ihartwig/pcie-mini-bridge/docs/five_pictures2_2542_20140408102417.png

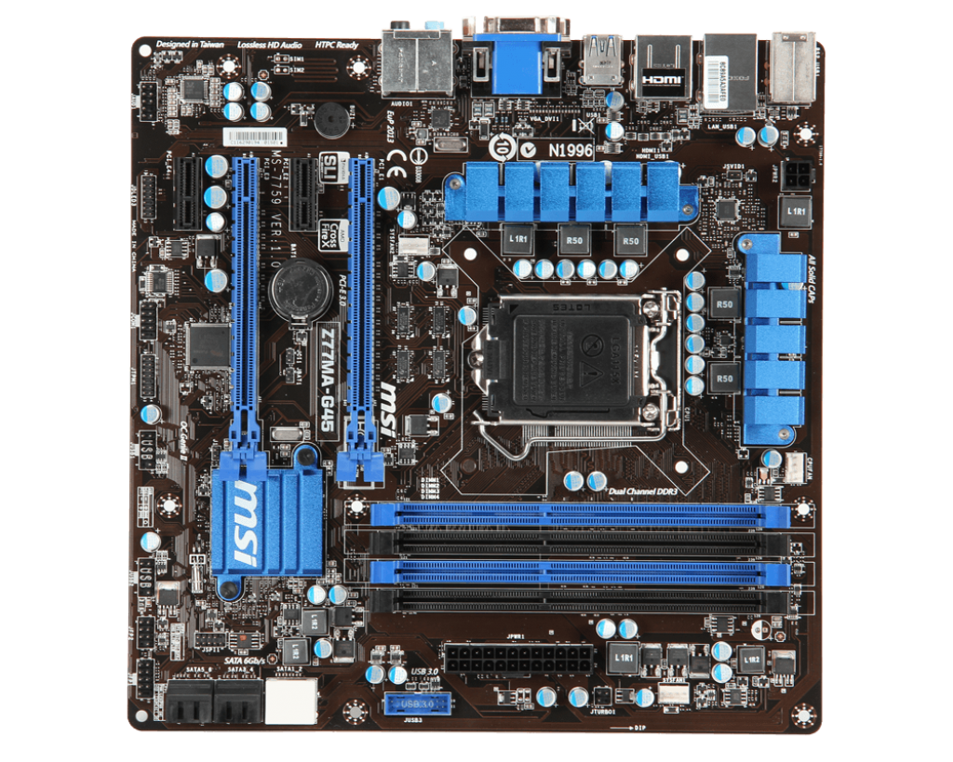
docs/five_pictures2_2542_20140408102417.png
