ihartwig/pcie-mini-bridge/docs/85ohm_diff_stripline_oshpark.png

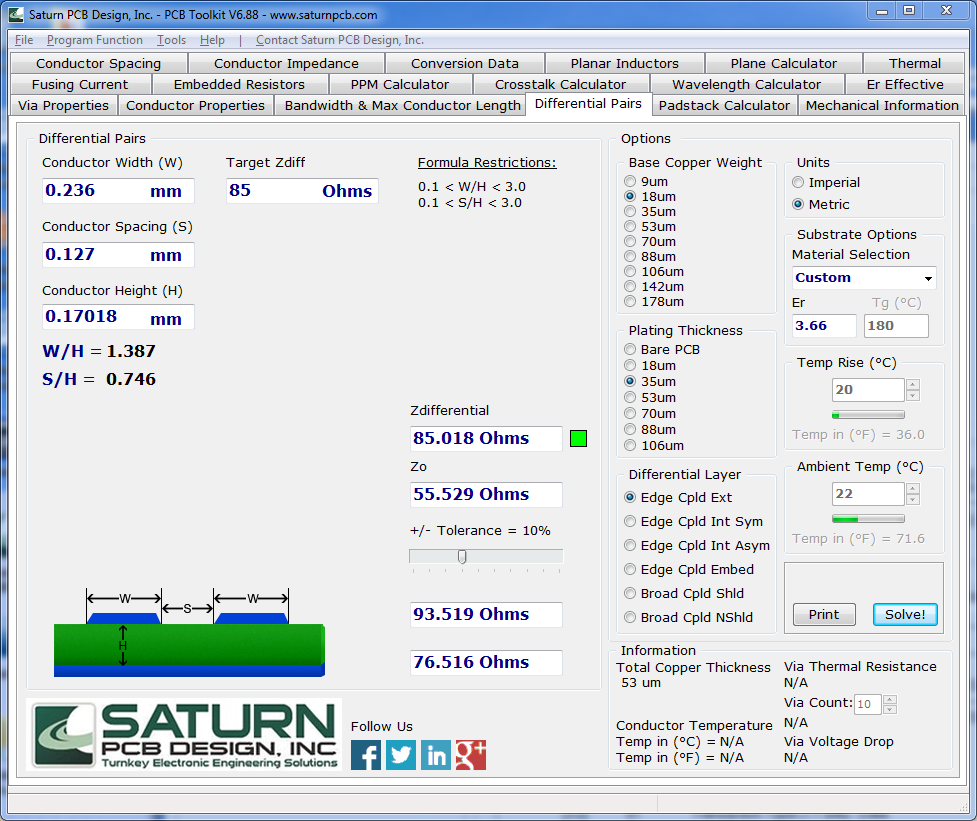
docs/85ohm_diff_stripline_oshpark.png
