ihartwig/pcie-mini-bridge/pcb/pcie-mini-bridge-dev.pdf

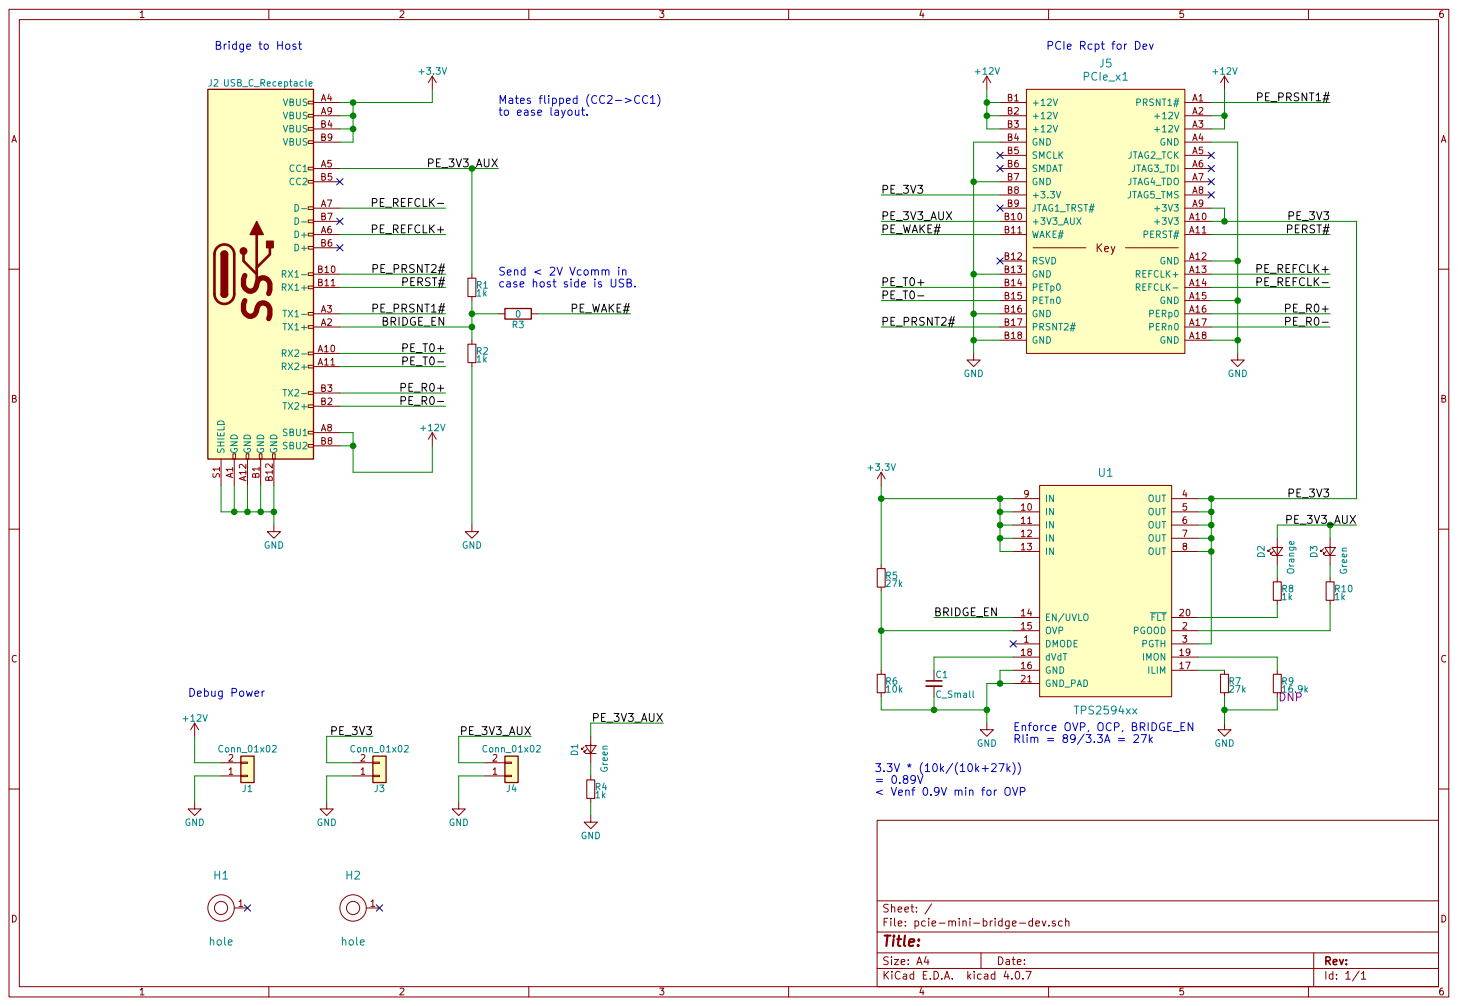
[picture p7: page 1]

< Venf 0.9V min for OVP
