ihartwig/pcie-mini-bridge/pcb/pcie-mini-bridge-host.pdf

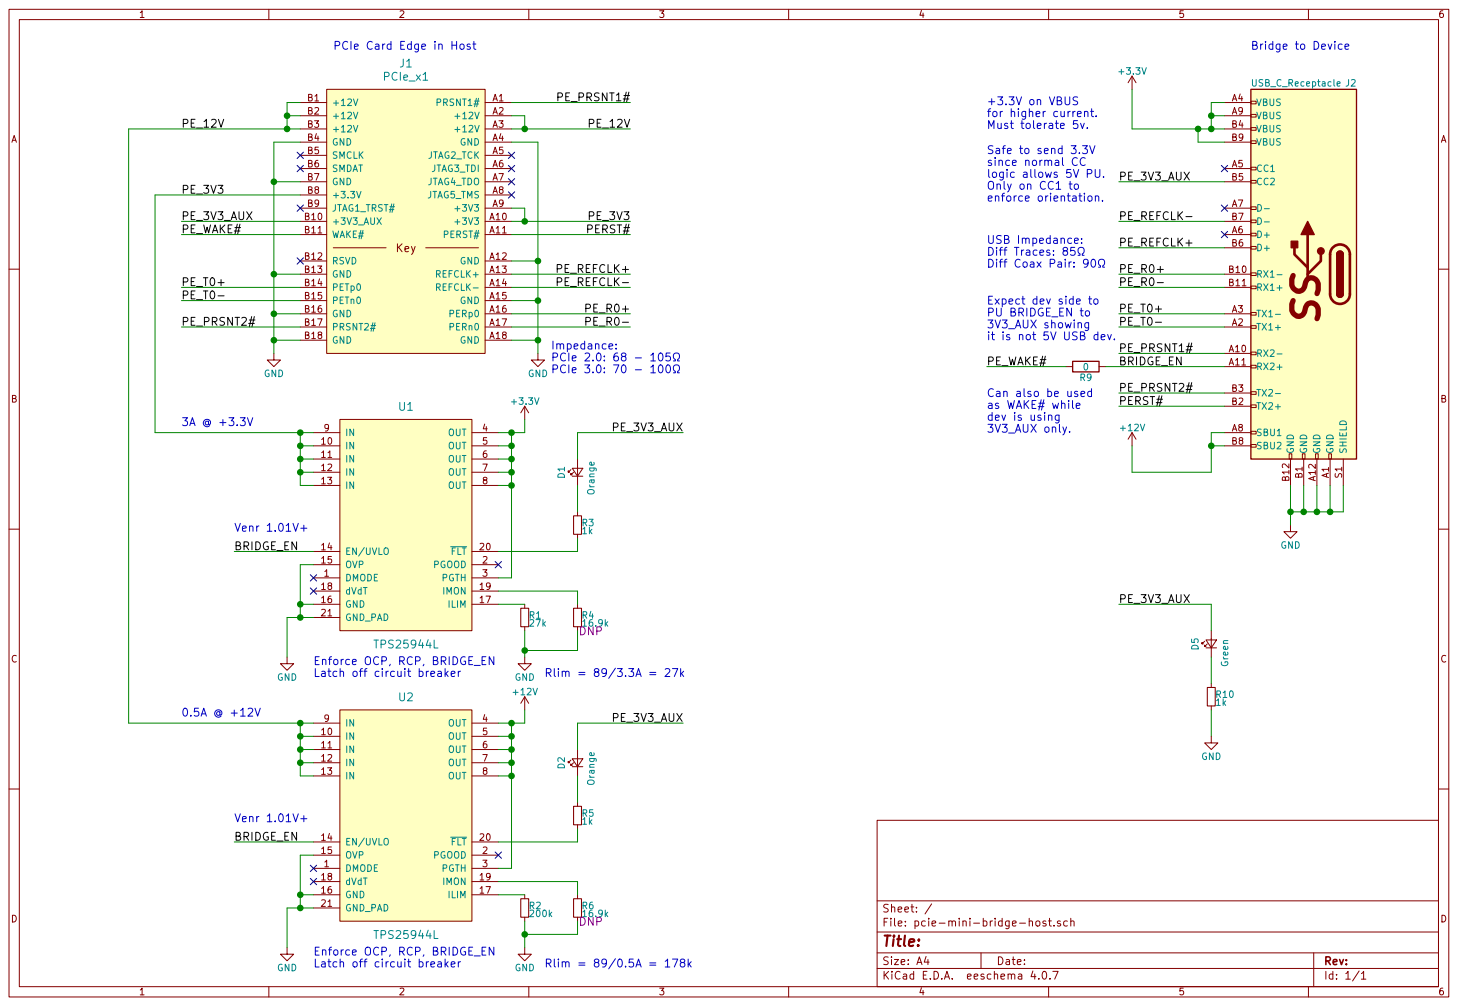
[picture p8: page 1]

Latch off circuit breaker BRIDGE_EN

USB Impedance: Diff Traces: 85 Diff Coax Pair: 90

Expect dev side to
PU BRIDGE_EN to
3V3_AUX showing
it is not 5V USB dev.

Can also be used as WAKE# while
dev is using
3V3_AUX only.

GND Enforce OCP, RCP, BRIDGE_EN
Latch off circuit breaker
