ihartwig/pcie-mini-bridge/docs/TE_x-1734857-x.pdf

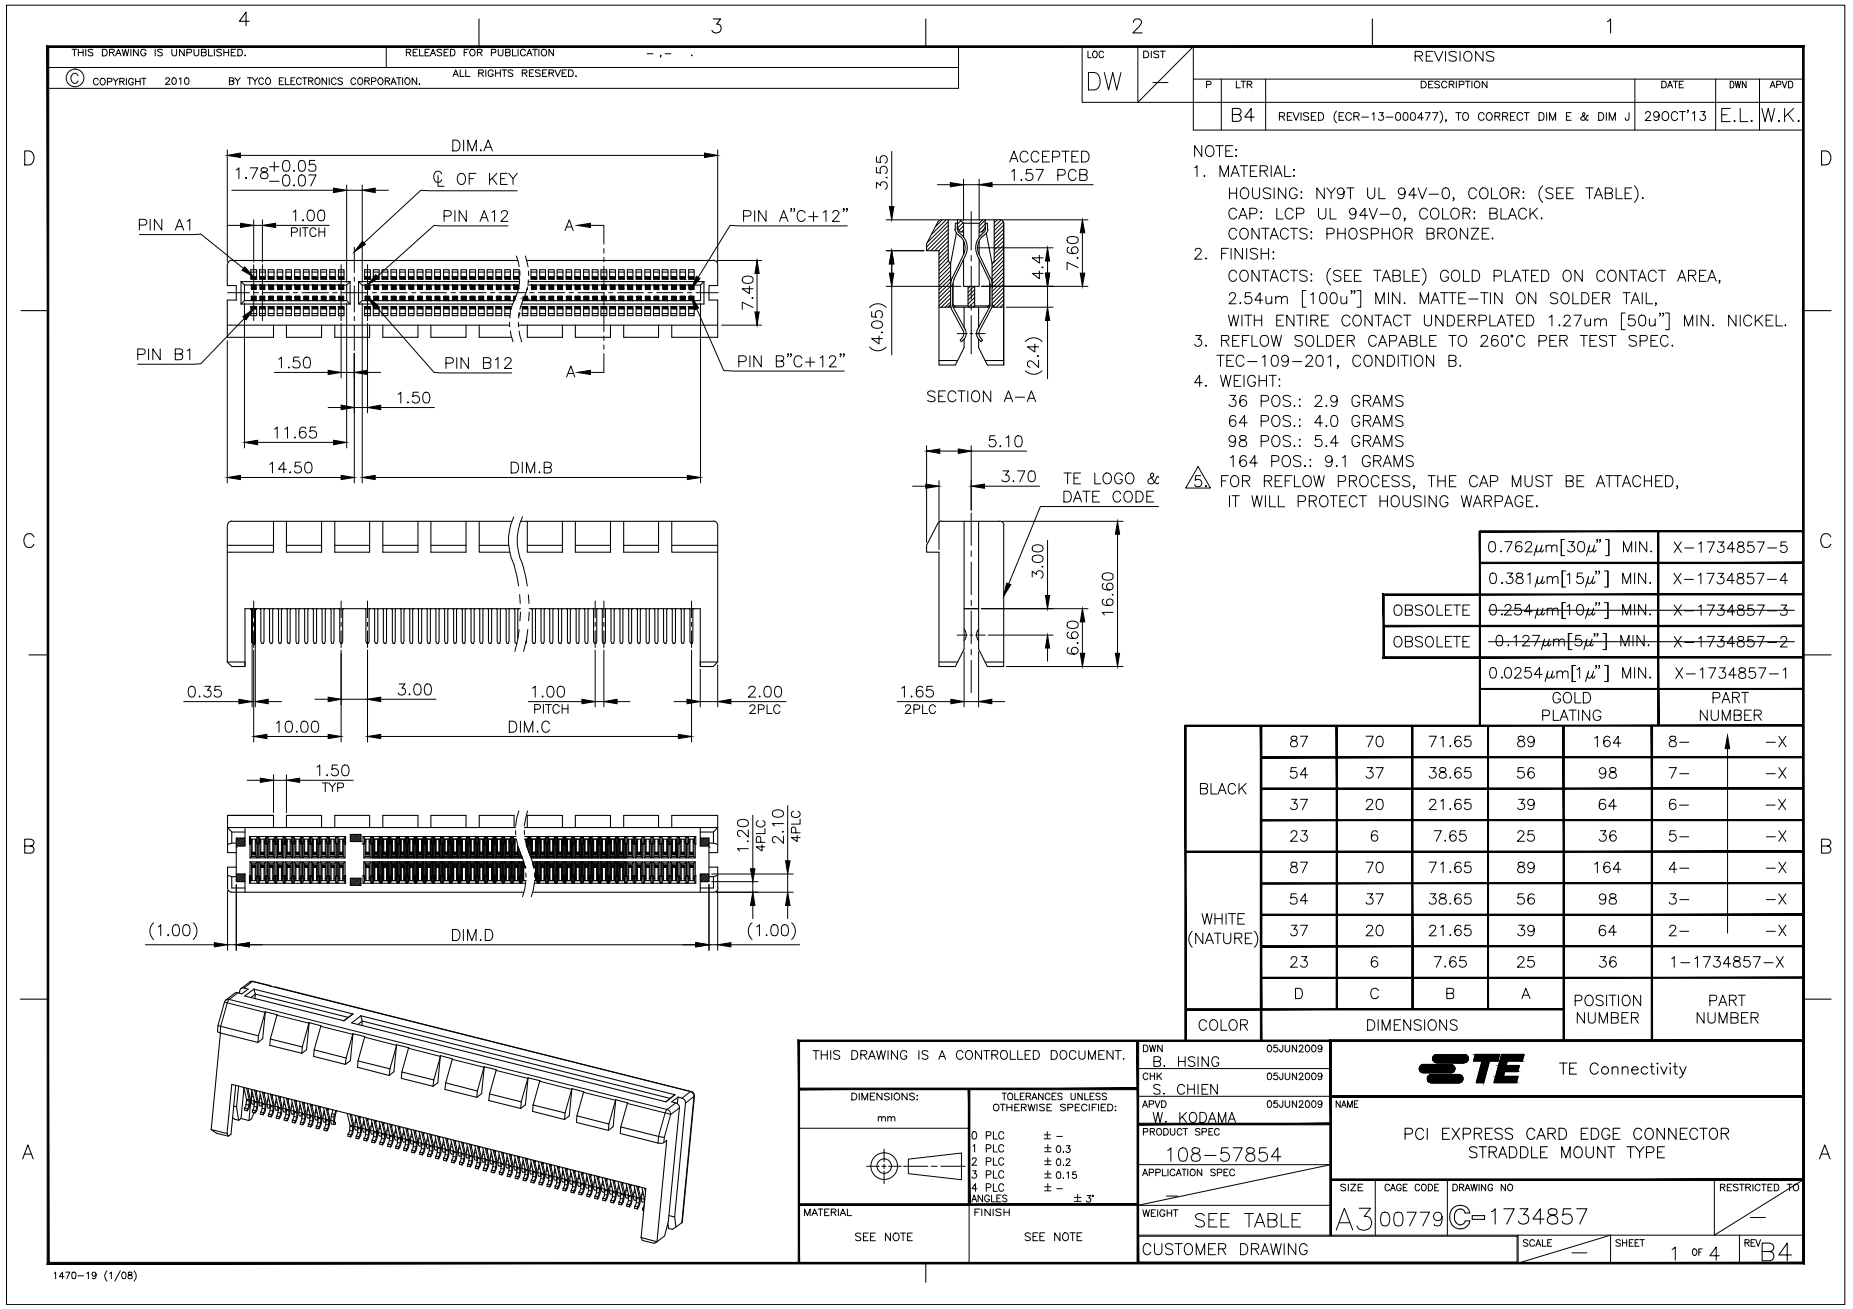
[picture p9: page 1]

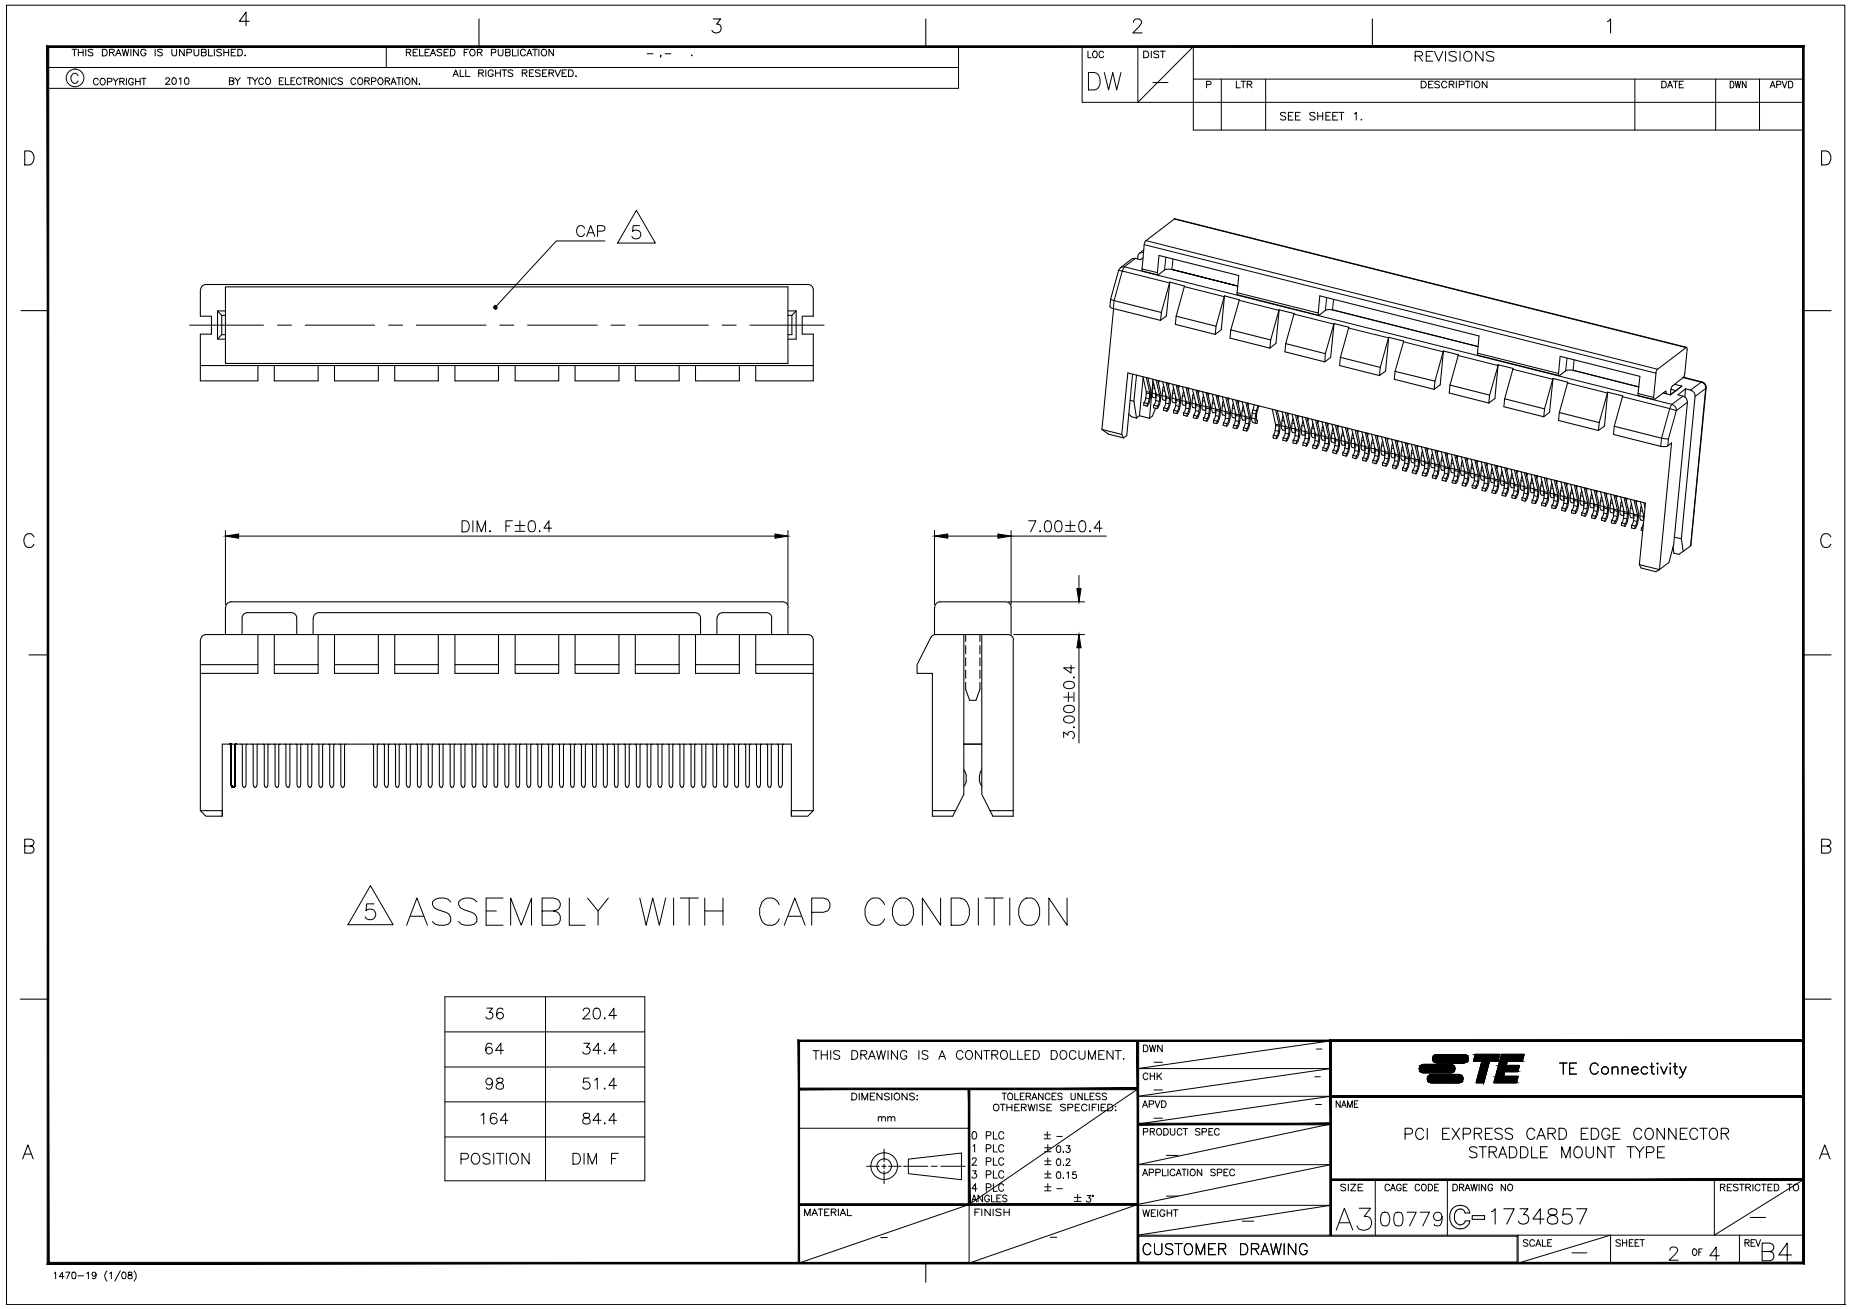
[picture p10: page 2]

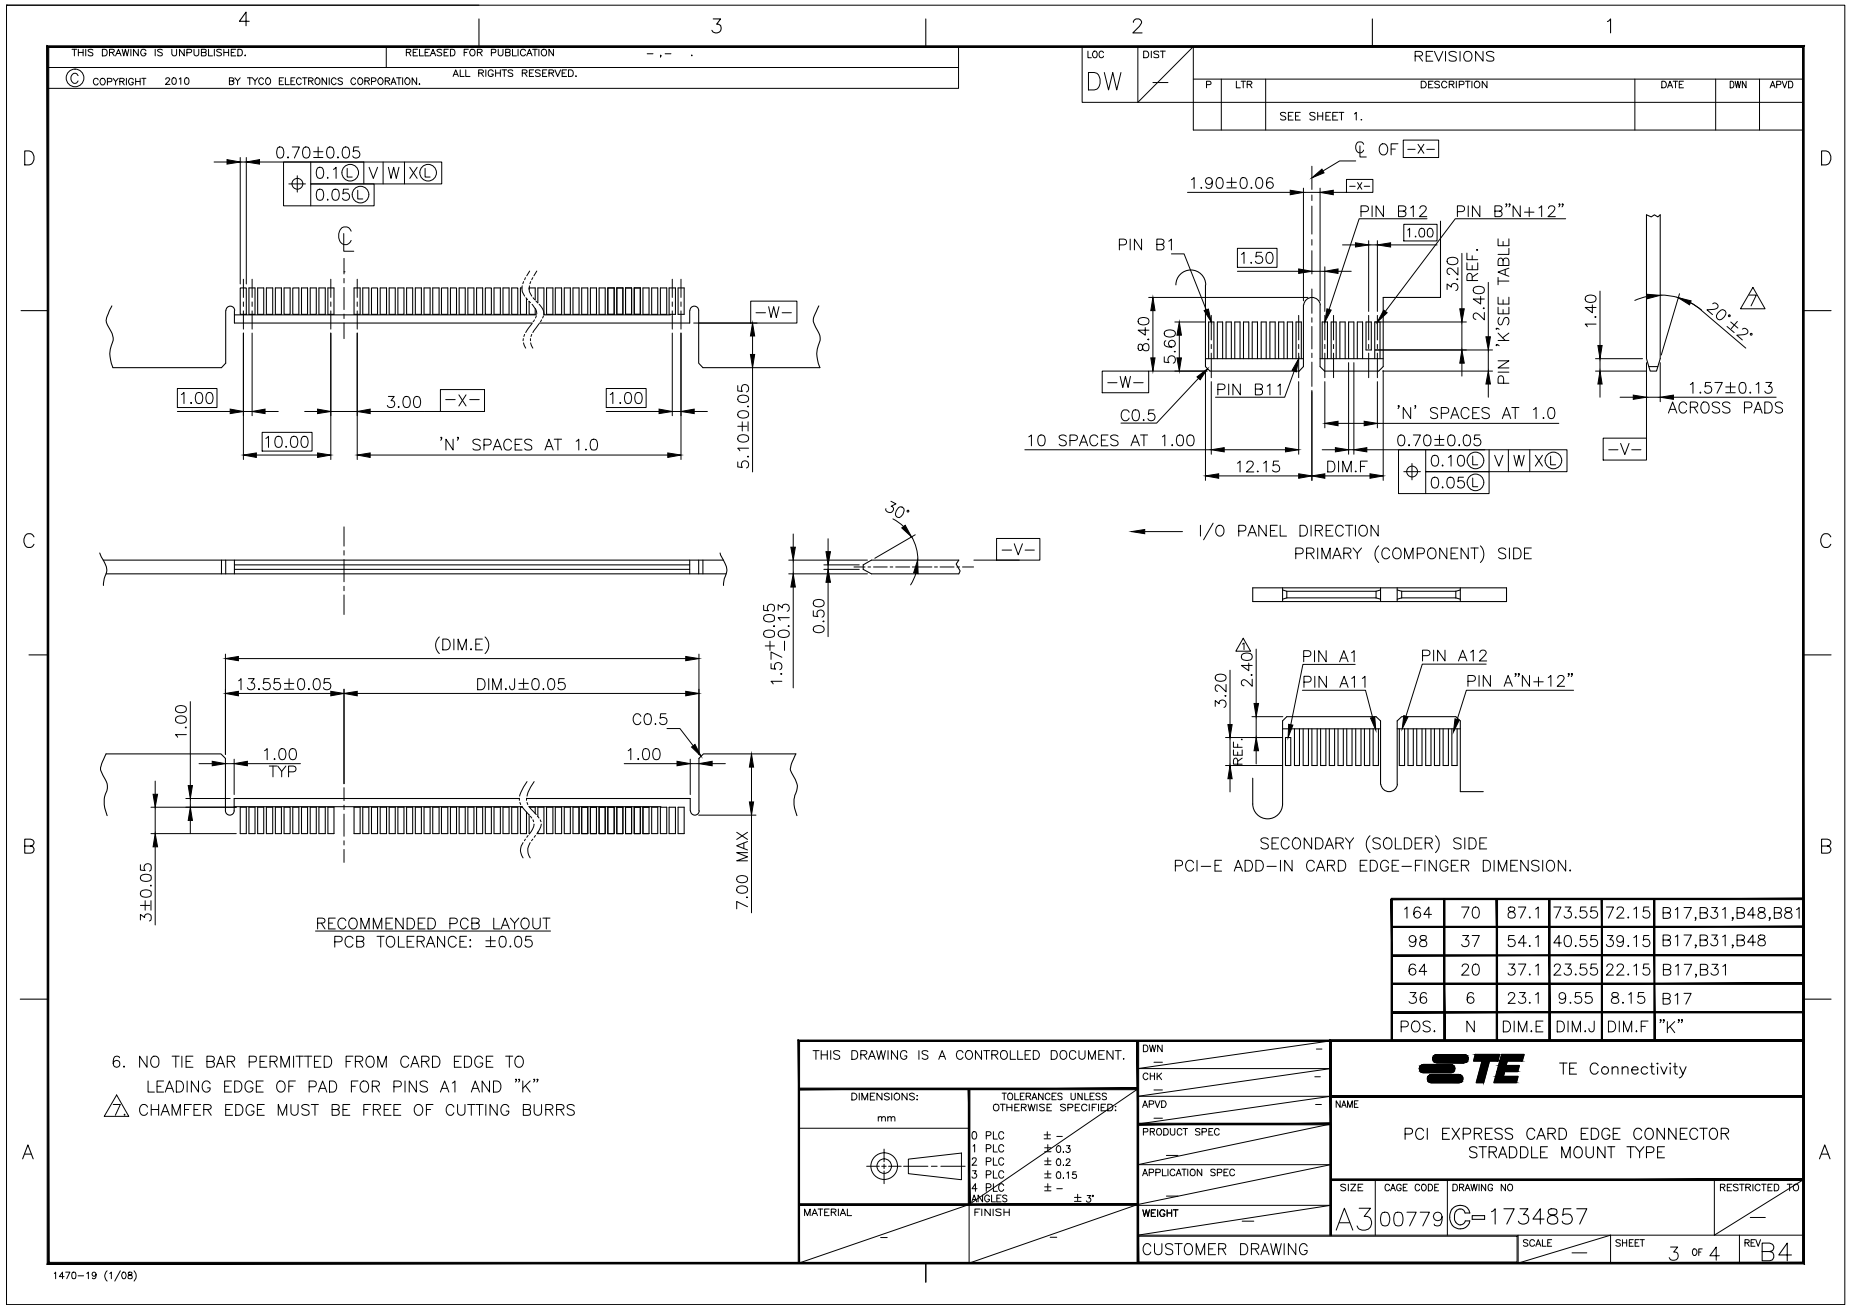
[picture p11: page 3]

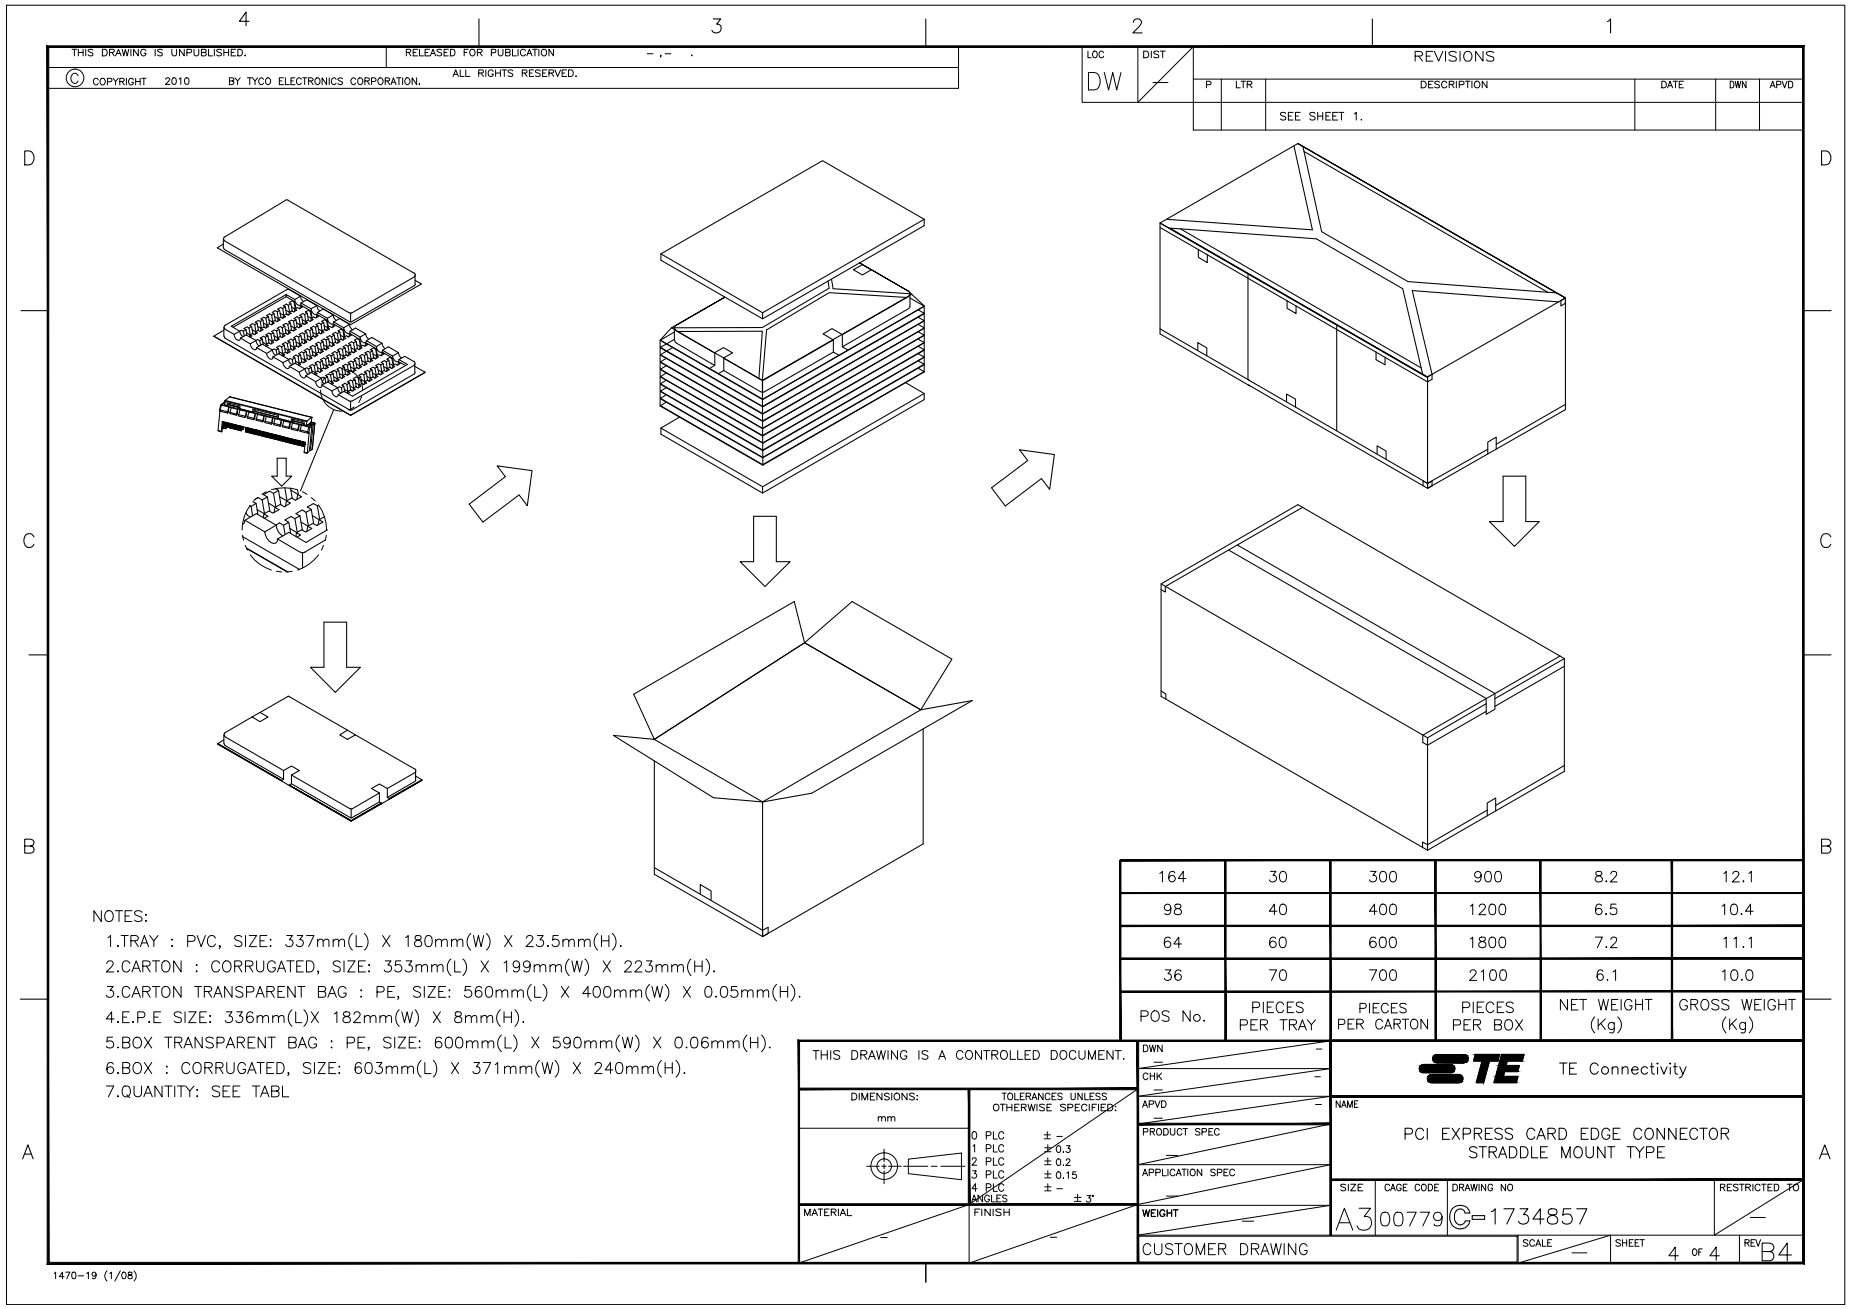
[picture p12: page 4]
