ihartwig/pcie-mini-bridge/pcb/pcie-mini-bridge-host.kicad_pcb

## KiCad design pcb/pcie-mini-bridge-host.kicad_pcb (2018-01-18)

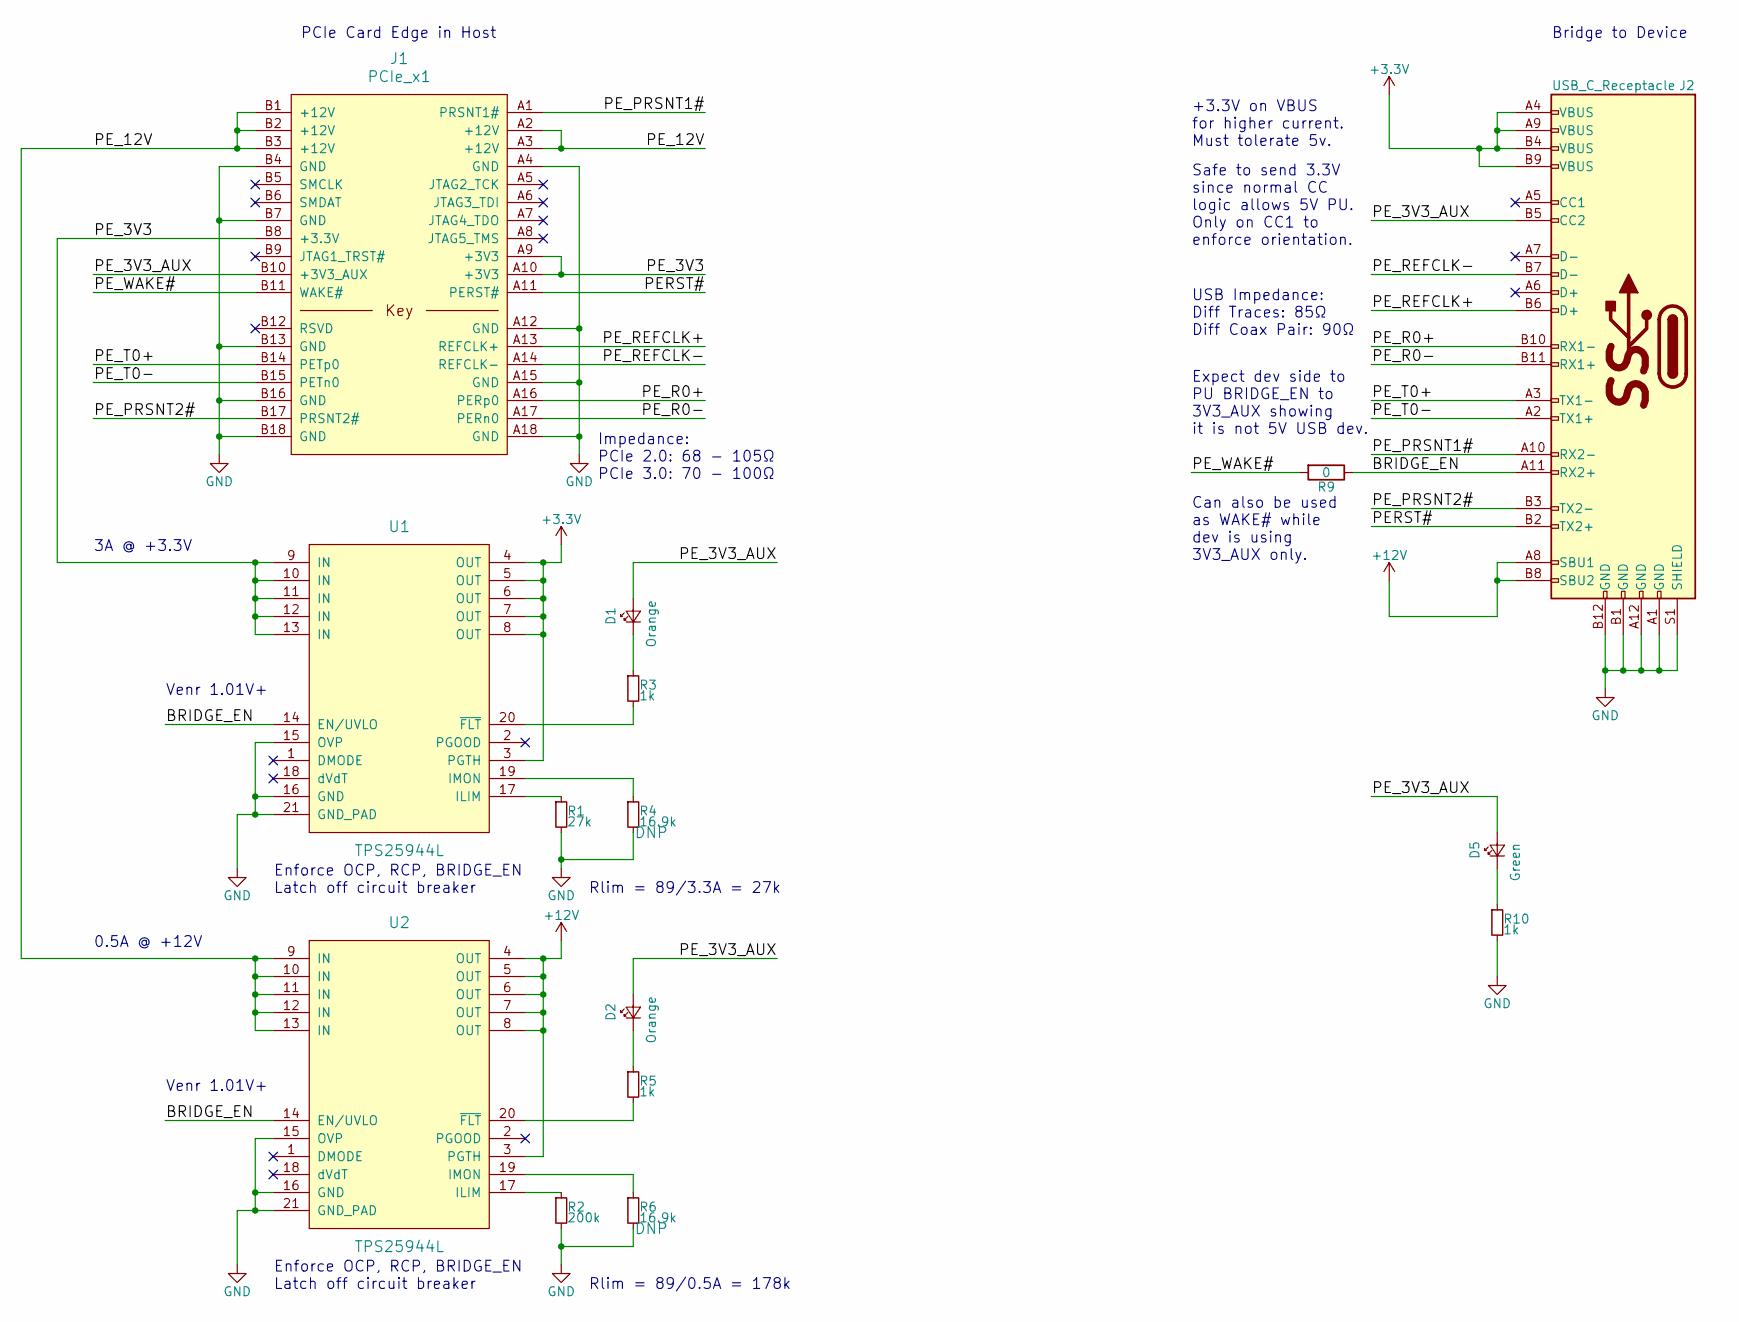
[picture p13: schematic pcie-mini-bridge-host.sch]

Parts:
D1, D2: Orange; LED_0603; Mfg Part No LTST-C190KFKT; Digikey Part No 160-1434-1-ND
D5: Green; LED_0603; Mfg Part No LTST-C190GKT; Digikey Part No 160-1183-1-ND
J1: PCIe_x1; PCIe_Fingers_x1
J2: USB_C_Receptacle; USB_C_Receptacle_Amphenol_12401610E4-2A; Mfg PN 12401548E4#2A; Digikey PN 12401548E4#2ACT-ND
R1: 27k; R_0603
R2: 200k; R_0603
R3, R5, R10: 1k; R_0603
R4, R6: 16.9k; R_0603
R9: 0; R_0603
U1, U2: TPS25944L; QFN-20-1EP_3x4mm_Pitch0.5mm; Mfg Part No TPS25944LRVCR; Digikey Part No 296-42152-1-ND

Connections:
+3V3: J2.A4 (VBUS), J2.A9 (VBUS), J2.B4 (VBUS), J2.B9 (VBUS), U1.3 (PGTH), U1.4 (OUT), U1.5 (OUT), U1.6 (OUT), U1.7 (OUT), U1.8 (OUT)
+12V: J2.A8 (SBU1), J2.B8 (SBU2), U2.3 (PGTH), U2.4 (OUT), U2.5 (OUT), U2.6 (OUT), U2.7 (OUT), U2.8 (OUT)
/BRIDGE_EN: J2.A11 (RX2+), R9.1, U1.14 (EN/UVLO), U2.14 (EN/UVLO)
/PERST#: J1.A11 (PERST#), J2.B2 (TX2+)
/PE_3V3: J1.A9 (+3V3), J1.A10 (+3V3), J1.B8 (+3.3V), U1.9 (IN), U1.10 (IN), U1.11 (IN), U1.12 (IN), U1.13 (IN)
/PE_3V3_AUX: D1.2 (A), D2.2 (A), D5.2 (A), J1.B10 (+3V3_AUX), J2.B5 (CC2)
/PE_12V: J1.A2 (+12V), J1.A3 (+12V), J1.B1 (+12V), J1.B2 (+12V), J1.B3 (+12V), U2.9 (IN), U2.10 (IN), U2.11 (IN), U2.12 (IN), U2.13 (IN)
/PE_PRSNT1#: J1.A1 (PRSNT1#), J2.A10 (RX2-)
/PE_PRSNT2#: J1.B17 (PRSNT2#), J2.B3 (TX2-)
/PE_R0+: J1.A16 (PERp0), J2.B10 (RX1-)
/PE_R0-: J1.A17 (PERn0), J2.B11 (RX1+)
/PE_REFCLK+: J1.A13 (REFCLK+), J2.B6 (D+)
/PE_REFCLK-: J1.A14 (REFCLK-), J2.B7 (D-)
/PE_T0+: J1.B14 (PETp0), J2.A3 (TX1-)
/PE_T0-: J1.B15 (PETn0), J2.A2 (TX1+)
/PE_WAKE#: J1.B11 (WAKE#), R9.2
GND: J1.A4 (GND), J1.A12 (GND), J1.A15 (GND), J1.A18 (GND), J1.B4 (GND), J1.B7 (GND), J1.B13 (GND), J1.B16 (GND), J1.B18 (GND), J2.A1 (GND), J2.A12 (GND), J2.B1 (GND), J2.B12 (GND), J2.S1 (SHIELD), R1.2, R2.2, R4.2, R6.2, R10.2, U1.15 (OVP), U1.16 (GND), U1.21 (GND_PAD), U2.15 (OVP), U2.16 (GND), U2.21 (GND_PAD)
unnamed: D1.1 (K), R3.1
unnamed: D2.1 (K), R5.1
unnamed: D5.1 (K), R10.1
unnamed: R1.1, U1.17 (ILIM)
unnamed: R2.1, U2.17 (ILIM)
unnamed: R3.2, U1.20 (~FLT)
unnamed: R4.1, U1.19 (IMON)
unnamed: R5.2, U2.20 (~FLT)
unnamed: R6.1, U2.19 (IMON)

Notes on the sheet:
Safe to send 3.3V since normal CC logic allows 5V PU. Only on CC1 to enforce orientation.
Expect dev side to PU BRIDGE_EN to 3V3_AUX showing it is not 5V USB dev.
Can also be used as WAKE# while dev is using 3V3_AUX only.
PCIe Card Edge in Host
Bridge to Device
0.5A @ +12V
3A @ +3.3V
+3.3V on VBUS for higher current. Must tolerate 5v.
Venr 1.01V+
Enforce OCP, RCP, BRIDGE_EN Latch off circuit breaker
Impedance: PCIe 2.0: 68 - 105Ω PCIe 3.0: 70 - 100Ω
Rlim = 89/3.3A = 27k
Rlim = 89/0.5A = 178k
USB Impedance: Diff Traces: 85Ω Diff Coax Pair: 90Ω

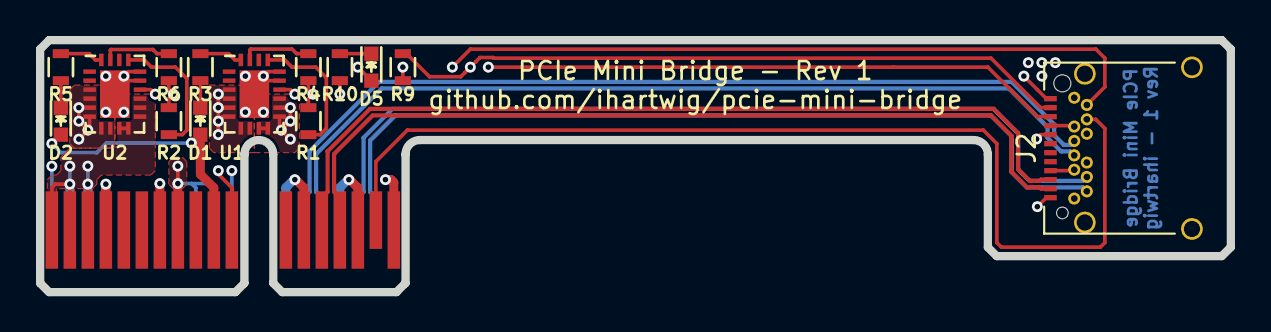
[picture p14: board pcie-mini-bridge-host.kicad_pcb from above]

Board: 4 copper layers, 66.2 x 14.0 mm, 15 parts (0 on the bottom side), 26 nets.
