ihartwig/pcie-mini-bridge/pcb/pcie-mini-bridge-dev.kicad_pcb

## KiCad design pcb/pcie-mini-bridge-dev.kicad_pcb (2018-01-18)

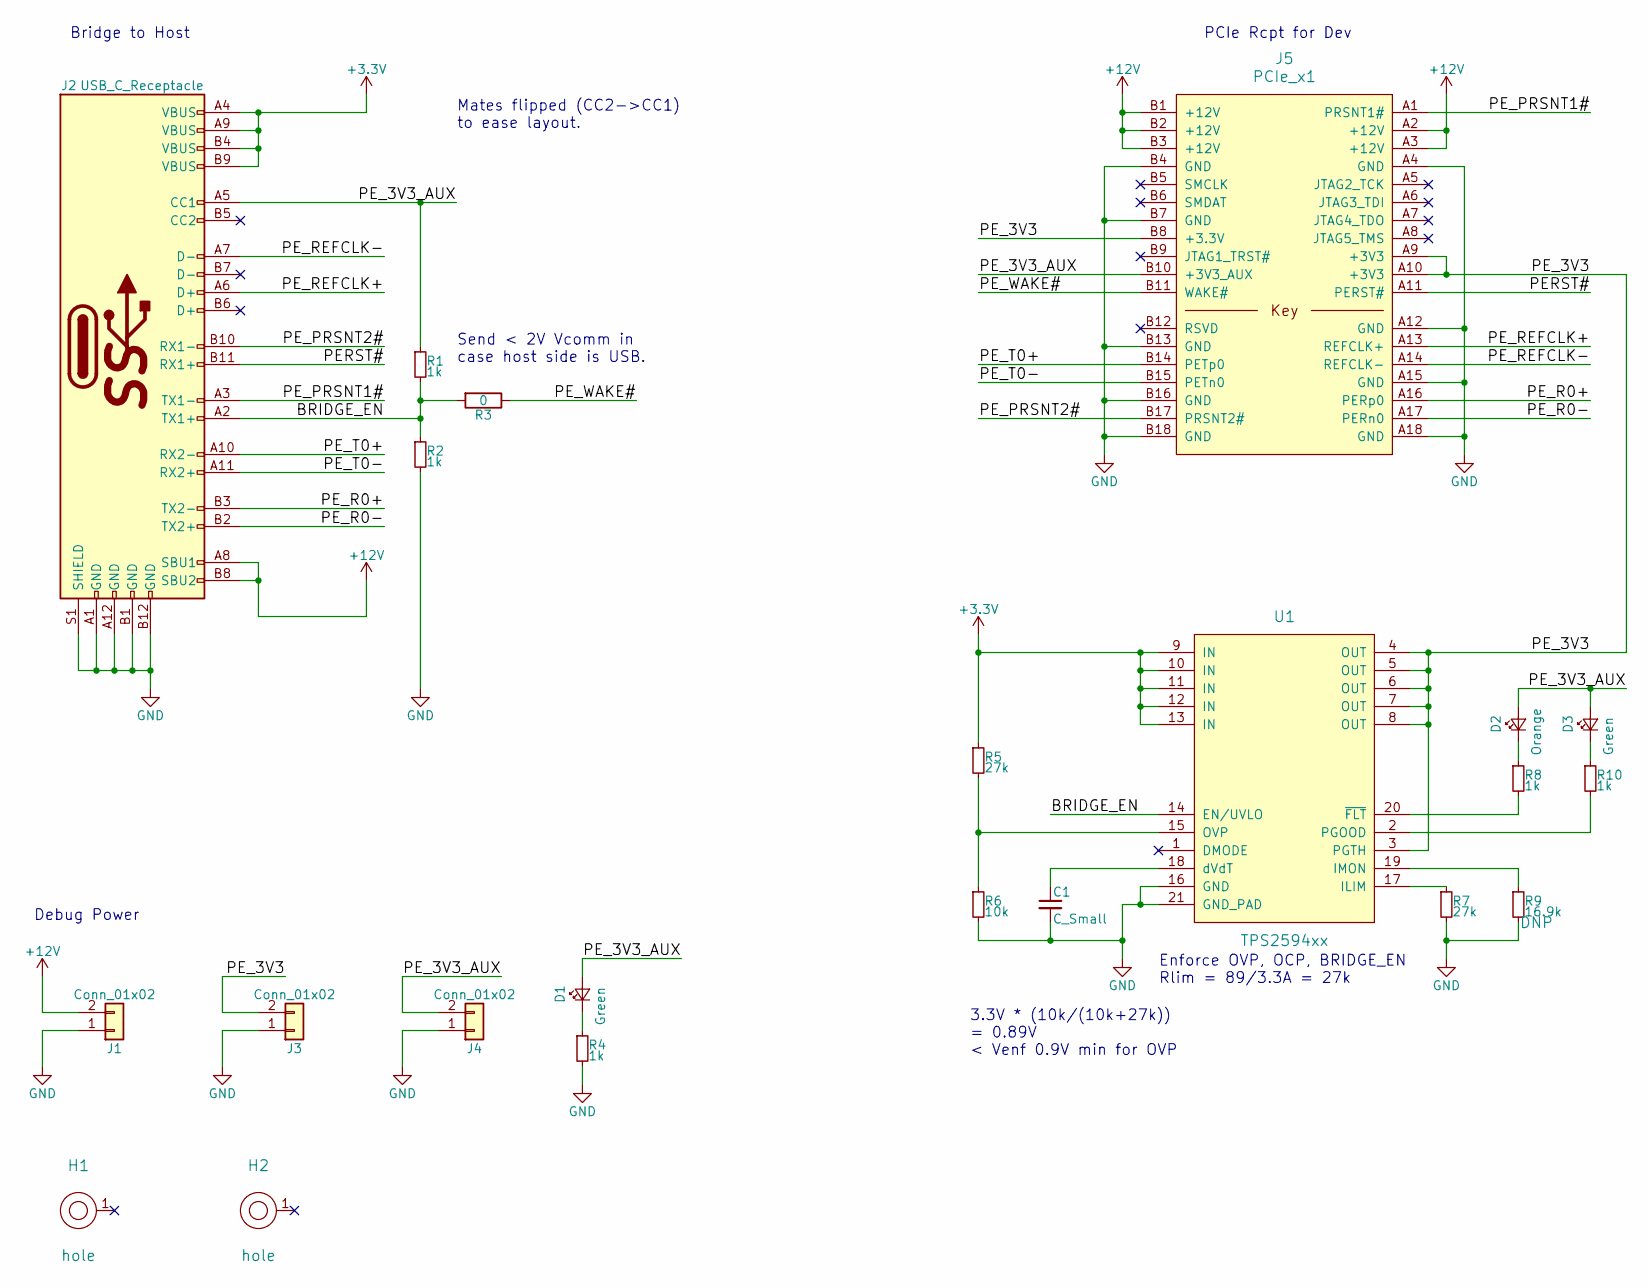
[picture p15: schematic pcie-mini-bridge-dev.sch]

Parts:
C1: C_Small; C_0603
D1, D3: Green; LED_0603; Mfg Part No LTST-C190GKT; Digikey Part No 160-1183-1-ND
D2: Orange; LED_0603; Mfg Part No LTST-C190KFKT; Digikey Part No 160-1434-1-ND
H1, H2: hole; hole-m3
J1, J3, J4: Conn_01x02; Pin_Header_Straight_1x02
J2: USB_C_Receptacle; USB_C_Receptacle_Amphenol_12401610E4-2A; Mfg PN 12401548E4#2A; Digikey PN 12401548E4#2ACT-ND
J5: PCIe_x1; PCIe_SMDEdge-NoPaste_TE_5-1734857-x; Mfg PN 5-1734857-5; Digikey PN A115312-ND
R1, R2, R4, R8, R10: 1k; R_0603
R3: 0; R_0603
R5, R7: 27k; R_0603
R6: 10k; R_0603
R9: 16.9k; R_0603
U1: TPS2594xx; QFN-20-1EP_3x4mm_Pitch0.5mm; Mfg Part No TPS25944LRVCR; Digikey Part No 296-42152-1-ND

Connections:
+3V3: J2.A4 (VBUS), J2.A9 (VBUS), J2.B4 (VBUS), J2.B9 (VBUS), R5.1, U1.9 (IN), U1.10 (IN), U1.11 (IN), U1.12 (IN), U1.13 (IN)
+12V: J1.2, J2.A8 (SBU1), J2.B8 (SBU2), J5.A2 (+12V), J5.A3 (+12V), J5.B1 (+12V), J5.B2 (+12V), J5.B3 (+12V)
/BRIDGE_EN: J2.A2 (TX1+), R1.2, R2.1, R3.2, U1.14 (EN/UVLO)
/PERST#: J2.B11 (RX1+), J5.A11 (PERST#)
/PE_3V3: J3.2, J5.A9 (+3V3), J5.A10 (+3V3), J5.B8 (+3.3V), U1.3 (PGTH), U1.4 (OUT), U1.5 (OUT), U1.6 (OUT), U1.7 (OUT), U1.8 (OUT)
/PE_3V3_AUX: D1.2 (A), D2.2 (A), D3.2 (A), J2.A5 (CC1), J4.2, J5.B10 (+3V3_AUX), R1.1
/PE_PRSNT1#: J2.A3 (TX1-), J5.A1 (PRSNT1#)
/PE_PRSNT2#: J2.B10 (RX1-), J5.B17 (PRSNT2#)
/PE_R0+: J2.B3 (TX2-), J5.A16 (PERp0)
/PE_R0-: J2.B2 (TX2+), J5.A17 (PERn0)
/PE_REFCLK+: J2.A6 (D+), J5.A13 (REFCLK+)
/PE_REFCLK-: J2.A7 (D-), J5.A14 (REFCLK-)
/PE_T0+: J2.A10 (RX2-), J5.B14 (PETp0)
/PE_T0-: J2.A11 (RX2+), J5.B15 (PETn0)
/PE_WAKE#: J5.B11 (WAKE#), R3.1
GND: C1.2, J1.1, J2.A1 (GND), J2.A12 (GND), J2.B1 (GND), J2.B12 (GND), J2.S1 (SHIELD), J3.1, J4.1, J5.A4 (GND), J5.A12 (GND), J5.A15 (GND), J5.A18 (GND), J5.B4 (GND), J5.B7 (GND), J5.B13 (GND), J5.B16 (GND), J5.B18 (GND), R2.2, R4.2, R6.2, R7.2, R9.2, U1.16 (GND), U1.21 (GND_PAD)
unnamed: C1.1, U1.18 (dVdT)
unnamed: D1.1 (K), R4.1
unnamed: D2.1 (K), R8.1
unnamed: D3.1 (K), R10.1
unnamed: R5.2, R6.1, U1.15 (OVP)
unnamed: R7.1, U1.17 (ILIM)
unnamed: R8.2, U1.20 (~FLT)
unnamed: R9.1, U1.19 (IMON)
unnamed: R10.2, U1.2 (PGOOD)

Notes on the sheet:
Send < 2V Vcomm in case host side is USB.
PCIe Rcpt for Dev
Bridge to Host
3.3V * (10k/(10k+27k)) = 0.89V < Venf 0.9V min for OVP
Enforce OVP, OCP, BRIDGE_EN Rlim = 89/3.3A = 27k
Debug Power
Mates flipped (CC2->CC1) to ease layout.

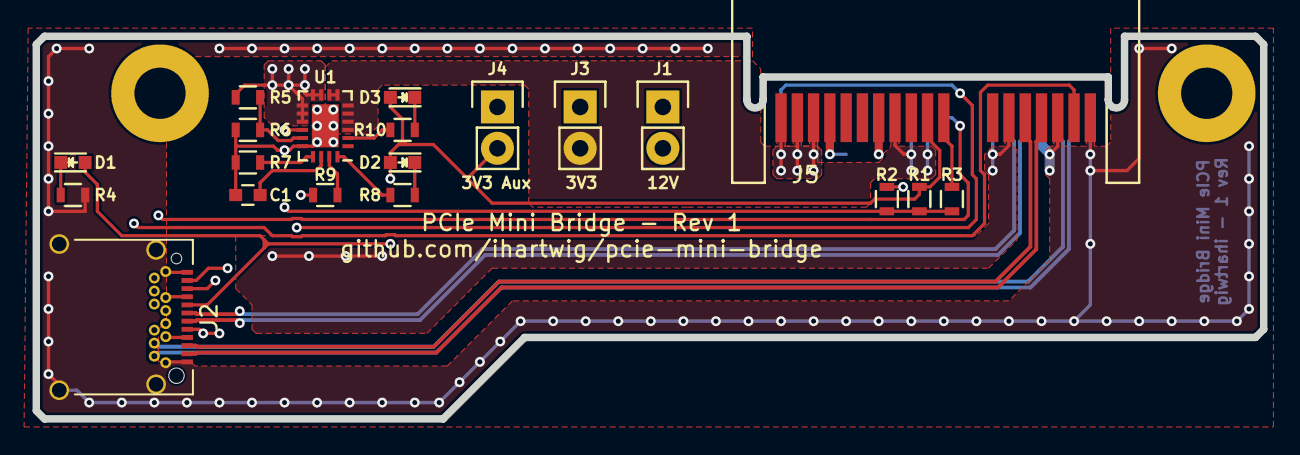
[picture p16: board pcie-mini-bridge-dev.kicad_pcb from above]

Board: 4 copper layers, 75.4 x 23.5 mm, 22 parts (0 on the bottom side), 25 nets.
