ihartwig/pcie-mini-bridge/(commit log)

2017-12-03 docs, schematic, footprints, host pcb layout
    [pcie-mini-bridge-dev.kicad_pcb, pcie-mini-bridge-dev.sch, pcie-mini-bridge-host.kicad_pcb, pcie-mini-bridge-host.sch]
2017-12-19 dev pcb layout, outline and hole parts
    [pcie-mini-bridge-dev.kicad_pcb, pcie-mini-bridge-dev.sch, pcie-mini-bridge-host.kicad_pcb]
2017-12-20 fix drc and dfm problems and make rev 1 gerbers
    * fix usb c recp. drc. change suggested .7/.4mm th/drills to .6728/.368mm th/drills to meet 6mil annular rings and 5mil spacing. remove slots.
    * clean up silk, add board labels
    * fix soldermask sizing to .051mm clearance with .077mm min width
    * remove PCIe length matching on host board because host + dev is correct length
    [pcie-mini-bridge-dev-B.Cu.gbl, pcie-mini-bridge-dev-B.Mask.gbs, pcie-mini-bridge-dev-B.Paste.gbp, pcie-mini-bridge-dev-B.SilkS.gbo, pcie-mini-bridge-dev-F.Cu.gtl, pcie-mini-bridge-dev-F.Mask.gts, pcie-mini-bridge-dev-F.Paste.gtp, pcie-mini-bridge-dev-F.SilkS.gto]
2018-01-18 fix pcie footprints and remove paste and update gerbers
    * fix PCIe_Fingers and PCIe_SMDEdge had bottom cu with top mask/paste
    * make and use PCIe_SMDEdge-NoPaste_TE_5-1734857-x
    [pcie-mini-bridge-dev-B.Cu.gbl, pcie-mini-bridge-dev-B.Mask.gbs, pcie-mini-bridge-dev-B.Paste.gbp, pcie-mini-bridge-dev-B.SilkS.gbo, pcie-mini-bridge-dev-F.Cu.gtl, pcie-mini-bridge-dev-F.Mask.gts, pcie-mini-bridge-dev-F.Paste.gtp, pcie-mini-bridge-dev-F.SilkS.gto]
2018-07-22 add schematic PDFs
